laika-001/bess-fw/laika-bess-hw/laika-bess-hw.kicad_sch

## KiCad design laika-bess-hw/laika-bess-hw.kicad_sch (2026-10-15)

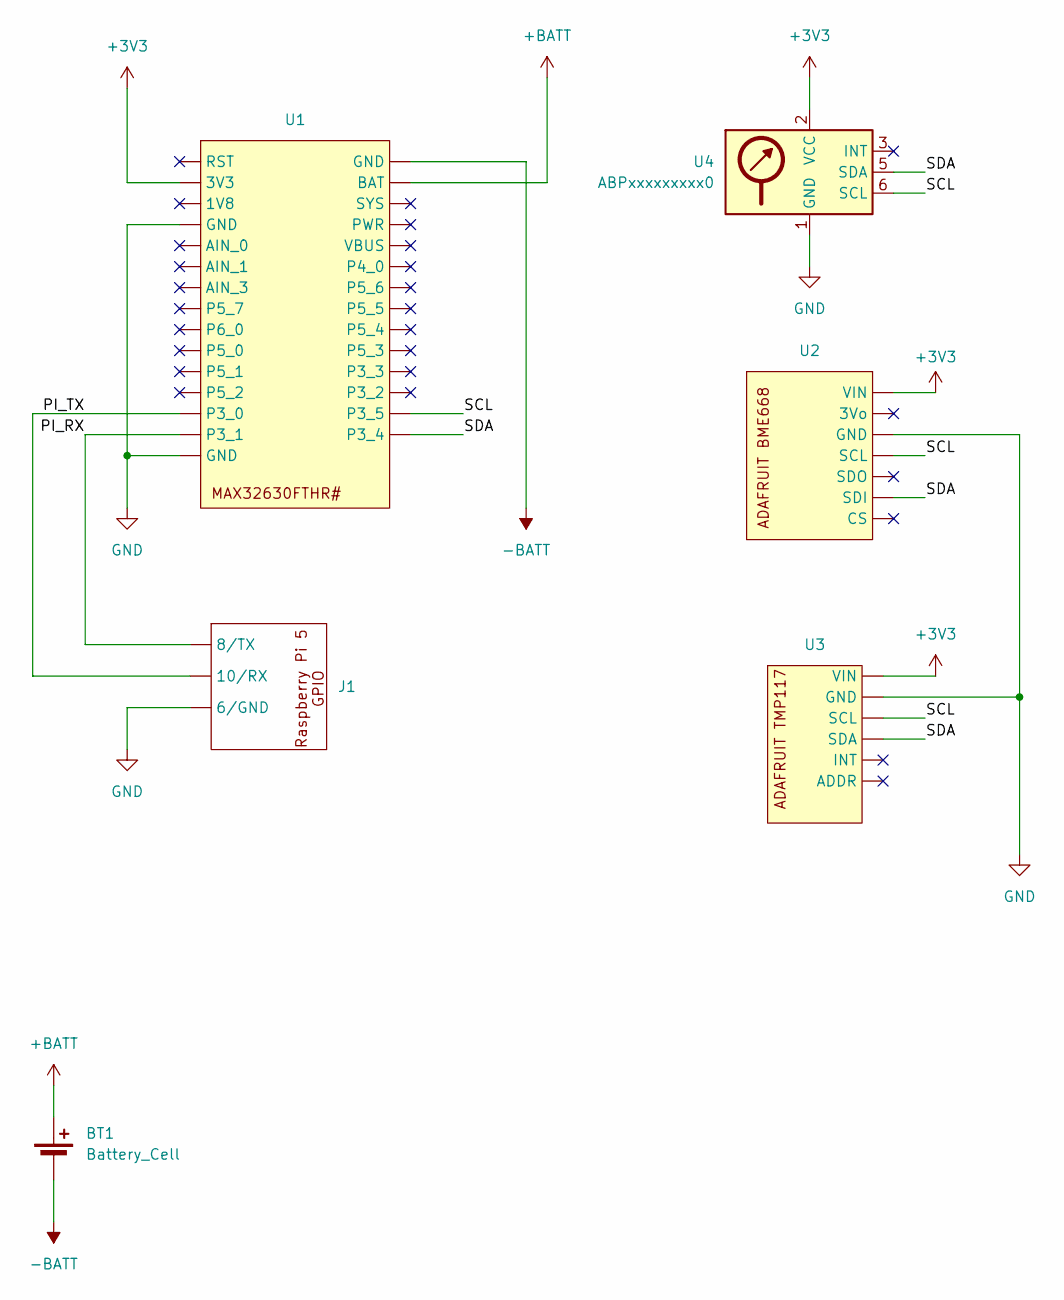
[picture p1: schematic laika-bess-hw.kicad_sch]

Parts:
BT1: Battery_Cell
J1: (no value)
U1, U2, U3: (no value)
U4: ABPxxxxxxxxx0

Connections:
+3V3: U1., U2., U3., U4.2 (VCC)
+BATT: BT1.1 (+), U1.
-BATT: BT1.2 (-), U1.
GND: J1., U1., U2., U3., U4.1 (GND)
PI_RX: J1., U1.
PI_TX: J1., U1.
SCL: U1., U2., U3., U4.6 (SCL)
SDA: U1., U2., U3., U4.5 (SDA)
