laika-001/bess-fw/(commit log)

2026-10-15 Initial commit: BESS module firmware, Pi dashboard and anomaly model
    MAX32630FTHR firmware (mbed-os, pinned in mbed-os.lib) for a battery
    enclosure monitor:
    - TMP117, Honeywell ABP2 (zero-offset corrected) and BME688 on I2C, with
    WDT0 watchdog and PMIC LDO bring-up.
    - BME688 through Bosch's BME68x driver and BSEC2 (IAQ, CO2-eq, bVOC-eq),
    calibration state saved to the last flash page.
    - $BESS data frames (protocol v3, CRC-16) on USB and on UART2 to the Pi.
    - On-board anomaly autoencoder (anomaly.h, weights from ml/).
    Bosch BSEC2 is not redistributed: tools/fetch_bsec.sh downloads the exact
    version from Bosch's GitHub after the user accepts Bosch's license, and
    verifies its checksums. se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
2026-10-15 Replace the on-board autoencoder with threshold rules
    Detection now uses explicit thresholds on gas, enclosure pressure and air
    temperature, decided on the module (rules.h, see DETECTION.md):
    - per channel: gas <= 60/35 % of its clean-air level, |dP| >= 50/200 Pa,
    TMP117 >= 45/60 degC, rise >= 1 degC/min, gas <= 80 % for an hour (leak);
    - possible battery event = two channels within a minute, or 60 degC.
    One channel alone is usually an everyday disturbance (people, a door,
    sun), so it is a warning, not the alarm.
    Replaying 10.5 h of real logs: no battery-event alarms; gas and pressure
    disturbances stayed single-channel. The autoencoder (in history up to
    349c6ce) sat in constant alarm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
2026-10-15 Stop tracking the KiCad PCB file; schematic stays in the repo
